piecol/GPS_LORA_TRACKER/Hardware/Schematic_LoRa_GPS_tracker_2022-12-14.pdf

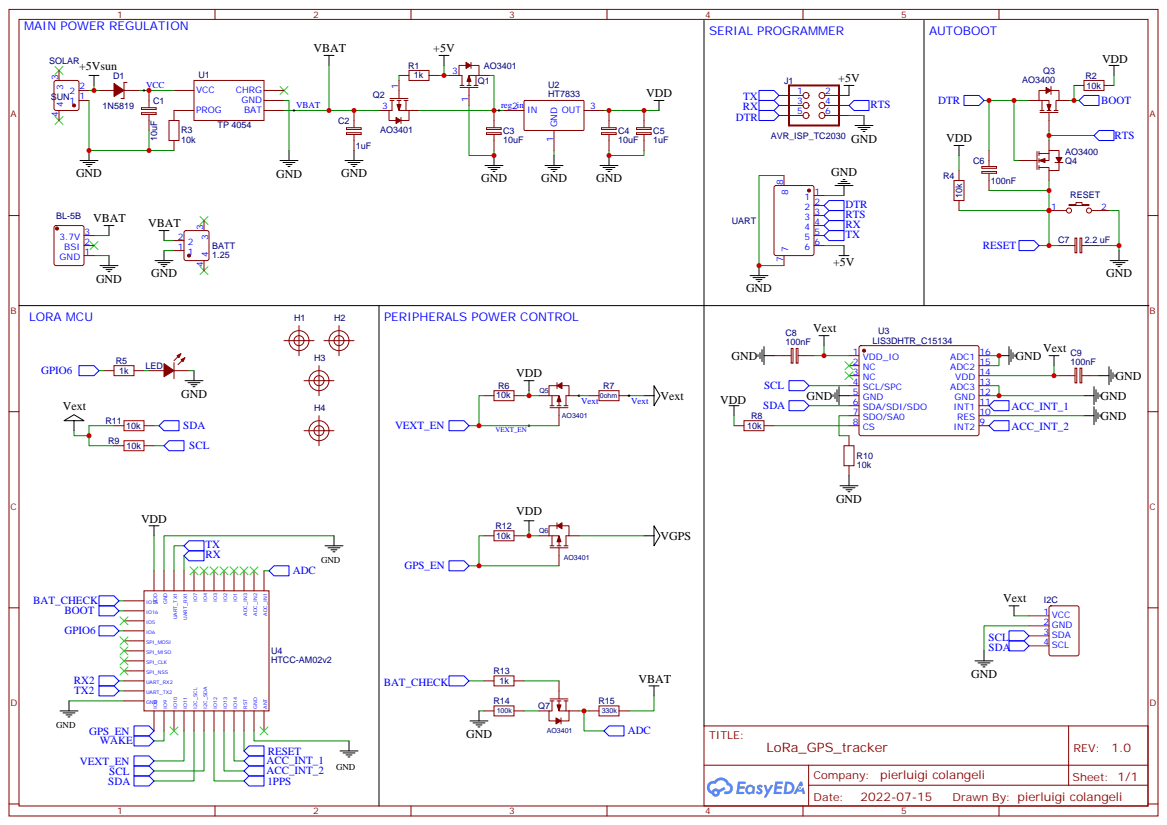
[picture p6: page 1]

Drawn By: pierluigi colangeli

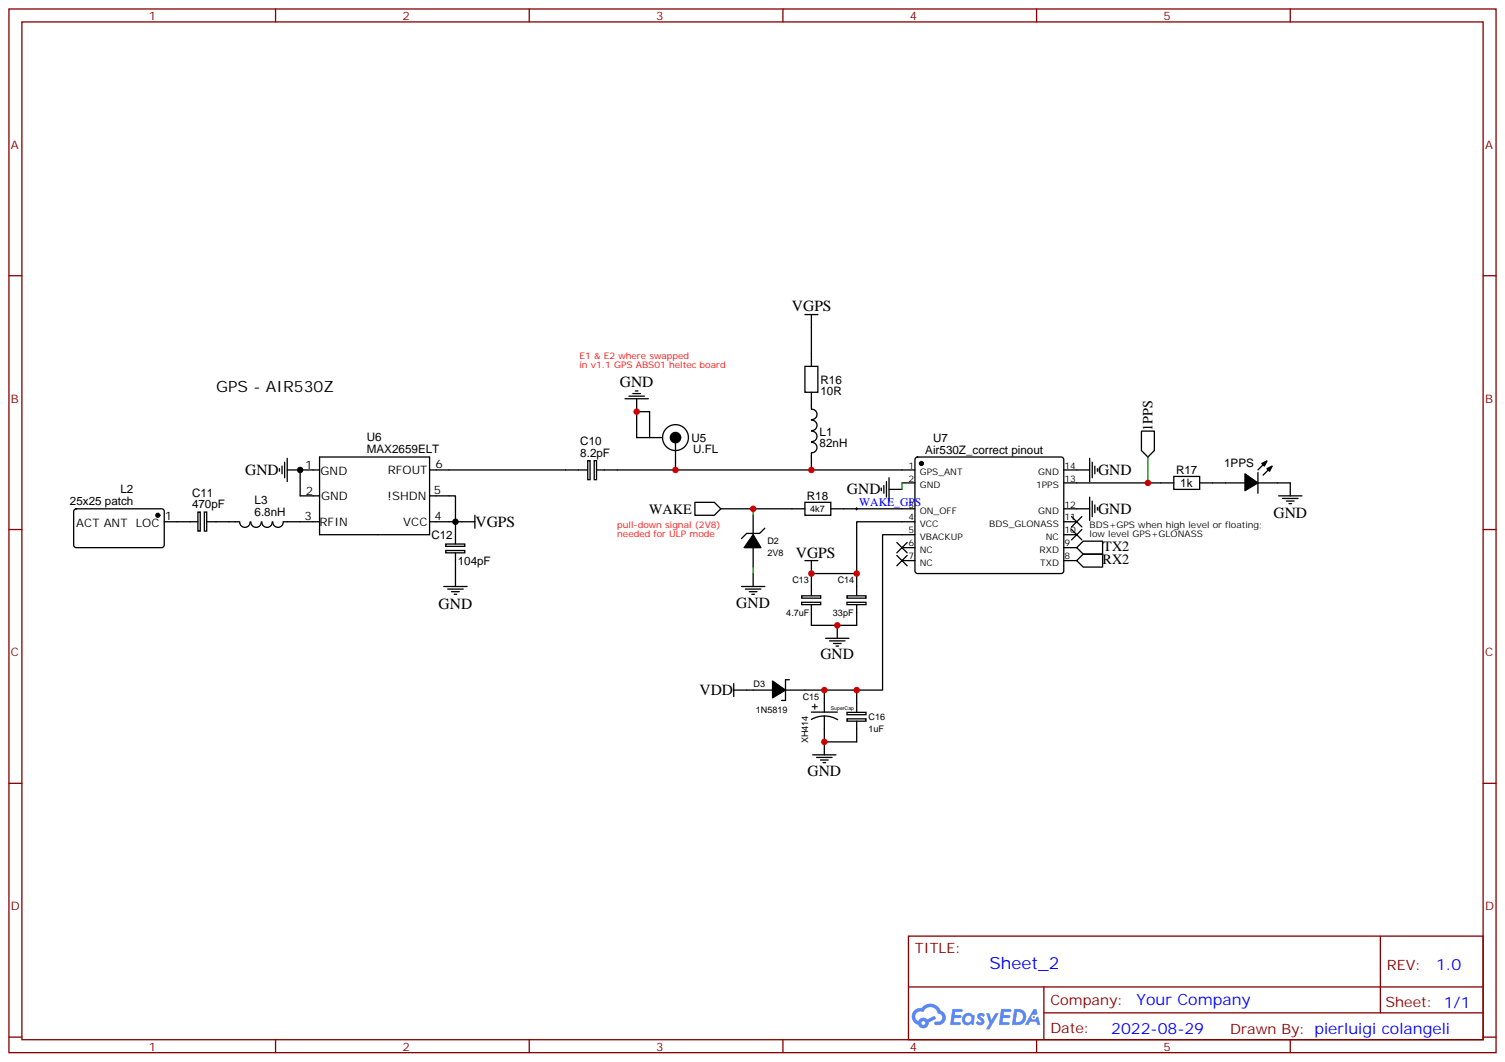
[picture p7: page 2]

E1 & E2 where swapped
in v1.1 GPS ABS01 heltec board
GND

WAKE
pull-down signal (2V8)
needed for ULP mode

BDS+GPS when high level or floating;
low level GPS+GLONASS

Drawn By: pierluigi colangeli
