piecol/GPS_LORA_TRACKER/AM02_GPS_LORA_V01/TTN.h

#ifndef TTN_H
#define TTN_H

/* OTAA para*/
uint8_t devEui[] = { 0x00, 0x03, 0x37, 0x35, 0x0F, 0x3A, 0x2A, 0xC6 };
uint8_t appEui[] = { 0x00, 0x00, 0x00, 0x00, 0x00, 0x00, 0x00, 0x00 };
uint8_t appKey[] = { 0xEB, 0xAE, 0x49, 0xE4, 0x75, 0x52, 0x07, 0x32, 0xF6, 0x8D, 0x28, 0x4E, 0x96, 0xA4, 0x27, 0x59 };

/* ABP para*/
uint8_t nwkSKey[] = { 0x00, 0x00, 0x00, 0x00, 0x00, 0x00, 0x00, 0x00, 0x00, 0x00, 0x00, 0x00, 0x00, 0x00, 0x00, 0x00 };
uint8_t appSKey[] = { 0x00, 0x00, 0x00, 0x00, 0x00, 0x00, 0x00, 0x00, 0x00, 0x00, 0x00, 0x00, 0x00, 0x00, 0x00, 0x00 };
uint32_t devAddr =  ( uint32_t )0x00000000;

/*LoraWan channelsmask, default channels 0-7*/ 
uint16_t userChannelsMask[6]={ 0x00FF,0x0000,0x0000,0x0000,0x0000,0x0000 };

/*LoraWan region, select in arduino IDE tools*/
LoRaMacRegion_t loraWanRegion = ACTIVE_REGION;

/*LoraWan Class, Class A and Class C are supported*/
DeviceClass_t  loraWanClass = LORAWAN_CLASS;

/*the application data transmission duty cycle.  value in [ms].*/
uint32_t appTxDutyCycle = 300000; //300000

/*OTAA or ABP*/
bool overTheAirActivation = LORAWAN_NETMODE;

/*ADR enable*/
bool loraWanAdr = LORAWAN_ADR;

/* set LORAWAN_Net_Reserve ON, the node could save the network info to flash, when node reset not need to join again */
bool keepNet = LORAWAN_NET_RESERVE;

/* Indicates if the node is sending confirmed or unconfirmed messages */
bool isTxConfirmed = LORAWAN_UPLINKMODE;

/* Application port */
uint8_t appPort = 2;

uint8_t confirmedNbTrials = 4;

#endif
