piecol/GPS_LORA_TRACKER/(commit log)

2022-12-14 electronic schematics
2023-02-16 download and open in browser
    interactive PCB BOM
